zhbi98/kicad-libs/kicad/test.kicad_pcb

## KiCad design kicad/test.kicad_pcb (2025-12-18)

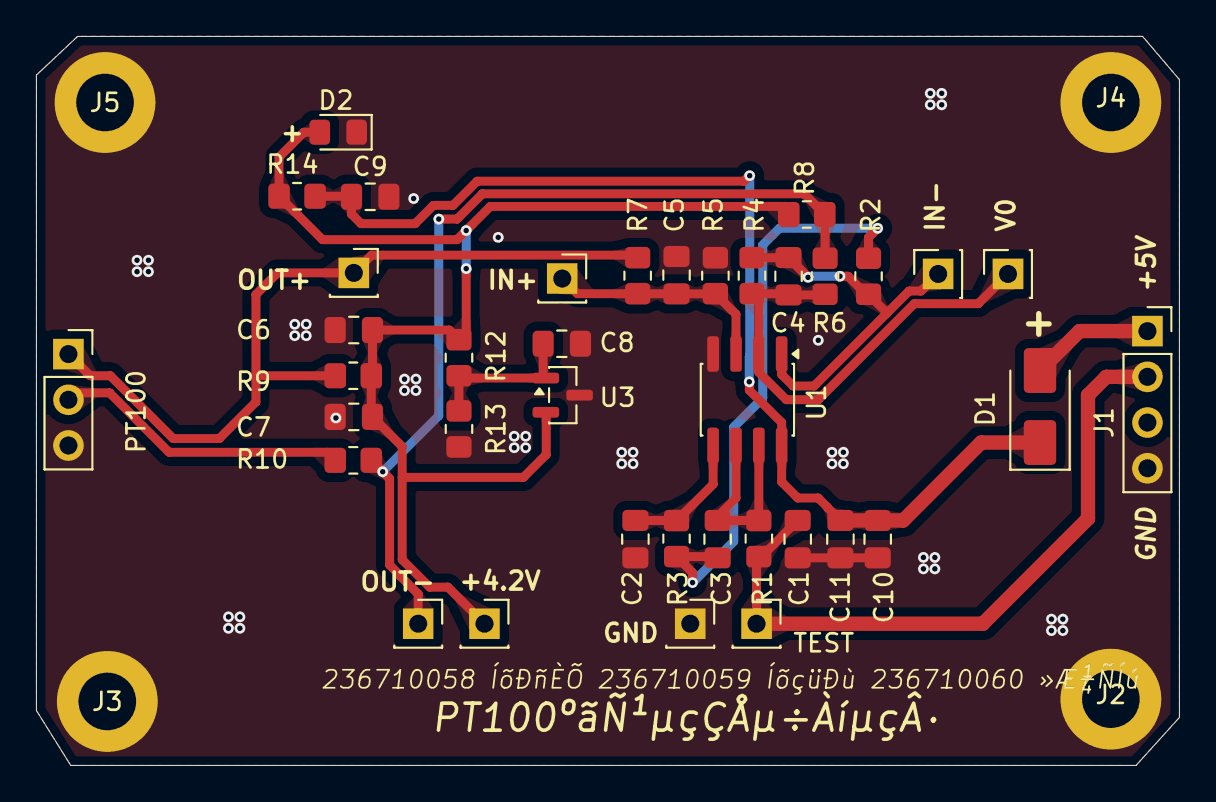
[picture p43: board test.kicad_pcb from above]

Board: 2 copper layers, 63.5 x 40.5 mm, 42 parts (0 on the bottom side), 15 nets.

Parts:
+4.2V: TP; PinSocket_1x01_P2.54mm_Vertical
C1, C7, C9, C10: 106; C_0805_2012Metric_Pad1.18x1.45mm_HandSolder
C2, C3, C6, C8, C11: 104; C_0805_2012Metric_Pad1.18x1.45mm_HandSolder
C4, C5: 100pF; C_0805_2012Metric_Pad1.18x1.45mm_HandSolder
D1: SS34; D_SMA
D2: LED; LED_0805_2012Metric_Pad1.15x1.40mm_HandSolder
GND: TP; PinSocket_1x01_P2.54mm_Vertical
IN+: TP; PinSocket_1x01_P2.54mm_Vertical
IN-: TP; PinSocket_1x01_P2.54mm_Vertical
J1: Header; PinSocket_1x04_P2.54mm_Vertical
J2, J3, J4, J5: T; MountingHole_3.2mm_M3_DIN965_Pad
OUT+: TP; PinSocket_1x01_P2.54mm_Vertical
OUT-: TP; PinSocket_1x01_P2.54mm_Vertical
PT100: PT100; PinSocket_1x03_P2.54mm_Vertical
R1, R6, R7: 1002; R_0805_2012Metric_Pad1.20x1.40mm_HandSolder
R2, R3: 1003; R_0805_2012Metric_Pad1.20x1.40mm_HandSolder
R4, R5: 4703; R_0805_2012Metric_Pad1.20x1.40mm_HandSolder
R8, R9: 4701; R_0805_2012Metric_Pad1.20x1.40mm_HandSolder
R10: 1000; R_0805_2012Metric_Pad1.20x1.40mm_HandSolder
R12: 5601; R_0805_2012Metric_Pad1.20x1.40mm_HandSolder
R13: 8201; R_0805_2012Metric_Pad1.20x1.40mm_HandSolder
R14: 51R; R_0805_2012Metric_Pad1.20x1.40mm_HandSolder
TEST: TP; PinSocket_1x01_P2.54mm_Vertical
U1: LM358; SOP-8_3.76x4.96mm_P1.27mm
U3: TL431DBZ; SOT-23
V0: TP; PinSocket_1x01_P2.54mm_Vertical

Connections:
+4.2V: +4.2V.1, C6.2, C7.2, D2.2 (A), R8.2, R9.2, R12.2, R14.1, U3.2 (K)
+5V: C9.2, C10.1, C11.1, D1.1 (K), R14.2, U1.8 (V+)
GND: C1.2, C2.2, C5.1, C6.1, C7.1, C8.1, C9.1, C10.2, C11.2, D2.1 (K), GND.1, J1.4, J2.1, J3.1, J4.1, J5.1, PT100.3, R5.1, R13.1, U1.4 (V-), U3.3 (A)
unnamed: C3.1, R2.2, R3.1
unnamed: C4.2, IN-.1, R2.1, R4.2, U1.1
unnamed: D1.2 (A), J1.1
unnamed: C1.1, J1.2, R1.2, TEST.1
unnamed: OUT+.1, PT100.1, R7.1, R9.1
unnamed: PT100.2, R10.1
unnamed: OUT-.1, R6.1, R8.1, R10.2
unnamed: C5.2, IN+.1, R5.2, R7.2, U1.3 (+)
unnamed: C4.1, R4.1, R6.2, U1.2 (-), V0.1
unnamed: C2.1, R3.2, U1.5 (+)
unnamed: C3.2, R1.1, U1.6 (-), U1.7
unnamed: C8.2, R12.1, R13.2, U3.1 (REF)
