zhbi98/kicad-libs/(commit log)

2023-02-25 合并封装库
2023-02-25 封装库整理
2023-02-25 增加规则 PDF 文件
2023-02-26 转换符号库文件格式
2023-02-26 添加封装
    [test.kicad_pcb, test.kicad_sch]
2023-02-26 添加封装内容
    [test.kicad_pcb, test.kicad_sch]
2023-02-26 修改封装参数
2023-02-27 常规更新封装
2023-02-28 更新封装参数
2023-03-01 添加器件符号和封装
2023-03-02 添加 TFT 卡槽封装
2023-03-02 修改通用连接器符号引脚编号
2023-03-03 增加封装
2023-03-04 增加 Mini 按键封装
2023-03-04 修改导线封装
2023-03-14 更新元器件封装
2023-04-15 添加芯片
2023-04-16 添加元器件封装
2023-04-18 更新器件符号
2023-04-22 添加封装和对应的3D模型
2023-04-22 添加USB-A封装
2023-12-10 重命名3D模型名称
2023-12-16 移除通用封装和模型的绑定，具体使用时再绑定
2023-12-17 更新符号库
2023-12-17 添加电机驱动芯片drv8301, MOSFET 符号封装3D模型
2023-12-17 添加磁编码器的符号和封装及3D模型
2023-12-18 添加LDO的符号和封装及3D模型，以及更新简介
    [WSON-6_L3.3-W3.0-P0.95_LP2992.stp]
2023-12-25 添加AMASS接口封装
2023-12-31 添加大电流焊盘式接口
2024-01-01 更新大电流焊接点封装
2024-01-01 修改封装3D模型，去除PCB
2024-01-01 增加AMASS大电流连接器3D模型，
2024-01-03 添加RJ45接口封装3D模型
2024-01-06 更新 MOS 管封装
2024-11-08 添加 SH1.0 垂直贴装接口座
2024-11-13 更新KiCAD库的使用说明
2024-11-14 添加立贴 SH1.0 插座封装
2024-11-15 添加立贴 USB,OLED0.96 128x64 屏幕封装
2024-11-15 添加E104-BT52蓝牙模组符号和封装，以及3D模型
    [test.kicad_sch]
2024-11-18 添加 USBC 16P 符号
2024-11-23 添加 JST 连接器3D模型与封装
2024-11-26 添加 JST 2P 封装
2024-11-28 更新电源焊接端子封装
2024-12-05 添加OLED屏幕封装和3D模型
2024-12-21 修改符号库，更新到最新版本
2024-12-28 修改JST排座封装轮廓区域
2025-12-18 更新 README, 和 kicad-libs 封装测试工程
    [test.kicad_pcb, test.kicad_sch]
2025-12-21 新增 LED 驱动芯片(包含LED5000,AL8860,TPS92365)库
    [test.kicad_sch]
2025-12-22 添加 GNSS 模组器件库，LICENSE，修改蓝牙库名称
2025-12-22 增加 Flash 元件，SO库增加封装，增加 TSSOP 封装库类型
2025-12-23 更新 README，增加注意事项小节
2025-12-31 添加WSON-8封装，添加LED驱动芯片TPS923651型号，调整WSON封装库设计
2026-01-14 修复丝印外框与焊盘安全预留空间重叠问题
2026-01-21 增加特殊3P-LED封装库文件，3dmodels 库文件
    [LED-SMD_3P-L5.7-W3.0-H0.8.step]
2026-02-03 更新LED5730封装错误，手册没有说明散热焊盘与阳极相连
